avierich/beepy-hardware/KiCad/beepy.kicad_pcb

## KiCad design KiCad/beepy.kicad_pcb (2024-08-15)

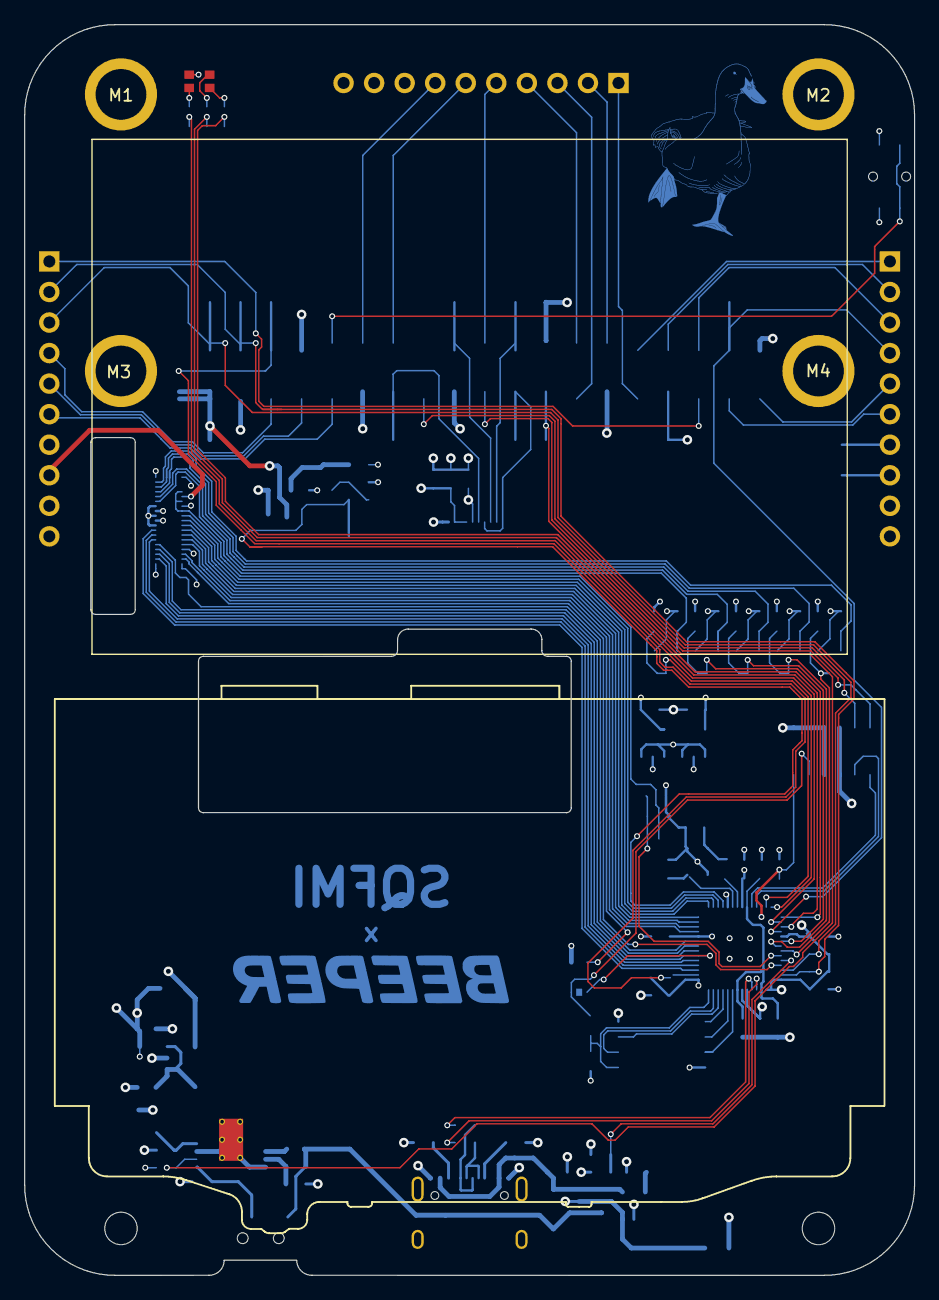
[picture p1: board beepy.kicad_pcb from above]

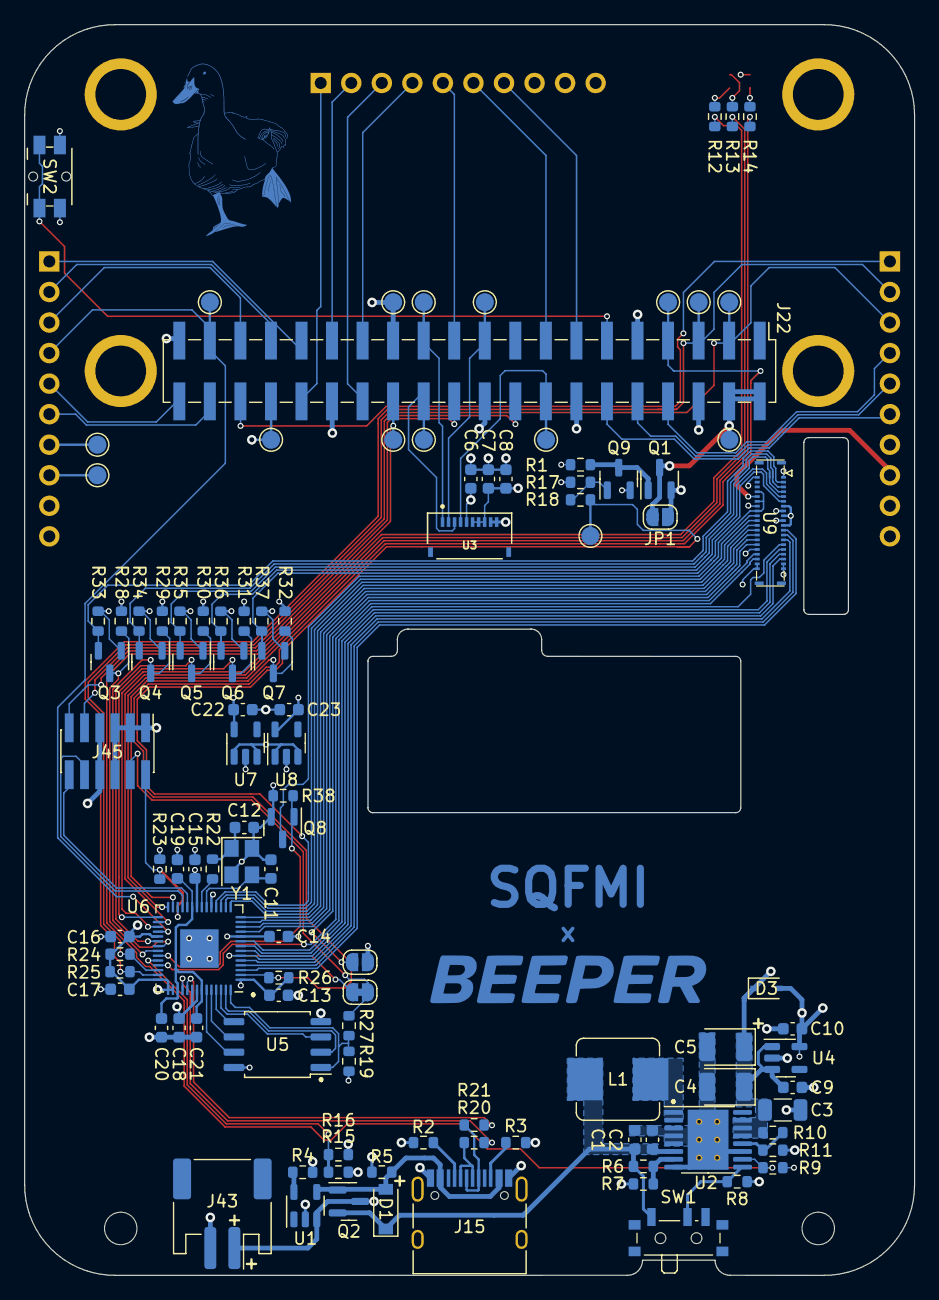
[picture p2: board beepy.kicad_pcb from below]

Board: 4 copper layers, 74.0 x 104.0 mm, 118 parts (115 on the bottom side), 100 nets.

Parts:
C1, C9, C10: 10uF; C_0603_1608Metric
C2, C6, C8: 100nF; C_0603_1608Metric
C3: 22uF; C_1206_3216Metric
C4, C5: 100uF; CP_EIA-3528-15_AVX-H
C7, C18, C21: 1uF; C_0603_1608Metric
C11, C12: 12pF; C_0603_1608Metric
C13, C14, C15, C16, C17, C19, C20, C22, C23: 0.1uF; C_0603_1608Metric
D1: B5819W; D_SOD-123
D2: Notification LED; FM-B2020RGBA-HG
D3: D_Schottky_Small; D_SOD-323
H1, H2: MountingHole; MountingHole_2.7mm_M2.5
J15: USB_C_Receptacle_USB2.0; USB_C_Receptacle_HRO_TYPE-C-31-M-12
J22: Pi Zero; PinHeader_2x20_P2.54mm_Vertical_SMD
J43: Battery; JST_PH_S2B-PH-SM4-TB_1x02-1MP_P2.00mm_Horizontal
J44: Header 1; PinHeader_1x10_P2.54mm_Vertical
J45: PRG_HEADER; PinHeader_2x06_P1.27mm_Vertical_SMD
J46: Header 2; PinHeader_1x10_P2.54mm_Vertical
J47: Header 3; PinHeader_1x10_P2.54mm_Vertical
JP1: PI PWR; SolderJumper-2_P1.3mm_Open_RoundedPad1.0x1.5mm
JP2: BOOTSEL_JUMPER; SolderJumper-2_P1.3mm_Bridged_RoundedPad1.0x1.5mm
JP3: SJ_MIC_VDD; SolderJumper-2_P1.3mm_Open_RoundedPad1.0x1.5mm
L1: 6.8uH/4A; L_Bourns_SRP7028A_7.3x6.6mm
M1, M2, M3, M4: MountingHole_2.5mm_Pad
Q1, Q2: SI2301; SOT-23
Q3, Q4, Q5, Q6, Q7, Q8: BSS138; SOT-23
Q9: S8050; SOT-23
R1, R4, R17, R19, R23, R26, R28, R29, R30, R31, R32, R33, R34, R35, R36, R37, R38: 10K; R_0603_1608Metric
R2, R3: 5.1K; R_0603_1608Metric
R5, R8, R15, R16: 100K; R_0603_1608Metric
R6, R10: 2M; R_0603_1608Metric
R7: 360K; R_0603_1608Metric
R9: 1M; R_0603_1608Metric
R11: 220K; R_0603_1608Metric
R12: 220; R_0603_1608Metric
R13, R14: 100; R_0603_1608Metric
R18: 330; R_0603_1608Metric
R20, R21: 27R; R_0603_1608Metric
R22, R27: 1K; R_0603_1608Metric
R24, R25: 4.7K; R_0603_1608Metric
REFe: SQFMI-DUCK-LOGO; SQFMI-DUCK-LOGO-BCU
SW1: ON/OFF; SW_SPDT_PCM12
SW2: Button; Panasonic_EVQPUL_EVQPUC
TP1, TP4, TP5, TP6, TP7, TP8, TP9, TP10, TP11, TP12, TP13, TP14, TP15, TP16, TP17: TestPoint; TestPoint_Pad_D1.5mm
U1: TP4054; SOT-23-5
U2: TPS61090; HTSSOP-16-1EP_4.4x5mm_P0.65mm_EP3.4x5mm_Mask2.46x2.31mm_The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
U3: LS027B7DH01; HRS_FH34SRJ-10S-0.5SH(50)
U4: AP2112K-3.3; SOT-23-5
U5: W25Q16JVSSIQ; SSOP-8_5.25x5.24mm_P1.27mm
U6: RP2040; QFN-56-1EP_7x7mm_P0.4mm_EP5.6x5.6mm
U7: ME6212C18M5G; SOT-23-5
U8: ME6212C28M5G; SOT-23-5
U9: BBQ20KBD; BM20B(0.8)-40DS-0.4V
Y1: XYDBPCNANF-12MHZ; Crystal_SMD_3225-4Pin_3.2x2.5mm

Connections:
+1V8: C22.1, Q3.1 (G), Q4.1 (G), Q5.1 (G), Q6.1 (G), Q7.1 (G), R33.2, R34.2, R35.2, R36.2, R37.2, U7.5 (OUT), U9.10 (1V8)
+2V8: C23.1, U8.5 (OUT), U9.8 (2V8)
+3V3: C6.1, C10.2, C13.1, C14.1, C15.1, C16.1, C17.1, C18.1, D2.3 (A), D3.2 (A), J44.7, J45.7, J45.8, J46.8, J47.8, JP3.1 (A), R9.2, R19.2, R23.1, R24.2, R25.1, R26.1, R28.2, R29.2, R30.2, R31.2, R32.2, TP13.1, U3.5 (DISP), U4.5 (VOUT), U5.8 (VDD), U6.1 (IOVDD), U6.10 (IOVDD), U6.22 (IOVDD), U6.33 (IOVDD), U6.42 (IOVDD), U6.43 (ADC_AVDD), U6.44 (VREG_VIN), U6.48 (USB_VDD), U6.49 (IOVDD), U7.1 (IN), U7.3 (EN), U8.1 (IN), U8.3 (EN), U9.34 (LEDA), U9.36 (LEDA)
+5V: C3.1, C4.1, C5.1, C7.1, C8.1, C9.1, D3.1 (K), J44.8, J47.7, JP1.1 (A), Q1.2 (S), R1.1, R10.1, TP14.1, U2.13 (VOUT), U2.14 (VOUT), U2.15 (VOUT), U3.6 (VDDA), U3.7 (VDD), U3.8 (EXTMODE), U4.1 (VIN), U4.3 (EN)
+BATT: J43.1, Q2.3 (D), R15.1, U1.3 (VBAT)
/Button: J22.11 (GPIO17), SW2.1 (A)
/DISP_CS: J22.24 (~CE0/GPIO8), TP6.1, U3.3 (SCS)
/DISP_EXTIN: J22.16 (GPIO23), TP1.1, U3.4 (EXTCOMIN)
/DISP_SCLK: J22.23 (SCLK0/GPIO11), TP8.1, U3.1 (SCLK)
/DISP_SI: J22.19 (MOSI0/GPIO10), TP5.1, U3.2 (SI)
/LBO: J22.26 (~CE1/GPIO7), R9.1, TP9.1, U2.10 (LBO)
/PI_HEADER_SWCLK: J22.22 (GPIO25), J45.11
/PI_HEADER_SWDIO: J22.18 (GPIO24), J45.9
/Pi_GPIO0: J22.27 (ID_SD/GPIO0), J46.4
/Pi_GPIO1: J22.28 (ID_SC/GPIO1), J46.3
/Pi_GPIO5: J22.29 (GCLK1/GPIO5), J46.2
/Pi_GPIO6: J22.31 (GCLK2/GPIO6), J44.1
/Pi_GPIO09: J22.21 (MISO0/GPIO9), J46.5
/Pi_GPIO12: J22.32 (PWM0/GPIO12), J46.1
/Pi_GPIO13: J22.33 (PWM1/GPIO13), J44.2
/Pi_GPIO14: J22.8 (GPIO14/TXD), J47.4
/Pi_GPIO15: J22.10 (GPIO15/RXD), J47.5
/Pi_GPIO16: J22.36 (GPIO16), J47.1
/Pi_GPIO18: J22.12 (GPIO18/PWM0), J47.6
/Pi_GPIO19: J22.35 (GPIO19/MISO1), J44.3
/Pi_GPIO20: J22.38 (GPIO20/MOSI1), J44.6
/Pi_GPIO21: J22.40 (GPIO21/SCLK1), J44.5
/Pi_GPIO22: J22.15 (GPIO22), J46.6
/Pi_GPIO26: J22.37 (GPIO26), J44.4, TP17.1, U6.32 (GPIO21)
/Pi_GPIO27: J22.13 (GPIO27), J46.7
/Pi_INT: J22.7 (GCLK0/GPIO4), R26.2, TP7.1, U6.2 (GPIO0)
/Pi_PWR: R18.1, TP10.1, U6.18 (GPIO15)
/Pi_SCL: J22.5 (SCL/GPIO3), J47.2, R25.2, TP12.1, U6.41 (GPIO29)
/Pi_SDA: J22.3 (SDA/GPIO2), J47.3, R24.1, TP11.1, U6.40 (GPIO28)
/RP2040/BATT_ADC: R15.2, R16.1, U6.38 (GPIO26)
/RP2040/COL1: U6.3 (GPIO1), U9.12 (COL1)
/RP2040/COL2: U6.4 (GPIO2), U9.13 (COL2)
/RP2040/COL3: U6.5 (GPIO3), U9.14 (COL3)
/RP2040/COL4: U6.9 (GPIO7), U9.15 (COL4)
/RP2040/COL5: U6.8 (GPIO6), U9.16 (COL5)
/RP2040/COL6: U6.7 (GPIO5), U9.17 (COL6)
/RP2040/COL7: JP2.1 (A), U6.6 (GPIO4), U9.18 (COL7)
/RP2040/D+: R21.1, U6.47 (USB_D+)
/RP2040/D-: R20.1, U6.46 (USB_D-)
/RP2040/KB_BL: Q8.1 (G), R38.1, U6.37 (GPIO25)
/RP2040/Keyboard/TP_MOTION_1V8: Q5.2 (S), R35.1, U9.4 (TP_MOTION)
/RP2040/Keyboard/TP_RESET_1V8: Q7.2 (S), R37.1, U9.6 (TP_RESET)
/RP2040/Keyboard/TP_SCL_1V8: Q4.2 (S), R34.1, U9.3 (TP_SCL)
/RP2040/Keyboard/TP_SDA_1V8: Q6.2 (S), R36.1, U9.5 (TP_SDA)
/RP2040/Keyboard/TP_SHUTDOWN_1V8: Q3.2 (S), R33.1, U9.2 (TP_SHUTDOWN)
/RP2040/LED_B: R14.1, U6.28 (GPIO17)
/RP2040/LED_G: R13.1, U6.30 (GPIO19)
/RP2040/LED_R: R12.1, U6.31 (GPIO20)
/RP2040/MIC: U6.39 (GPIO27), U9.23 (MIC)
/RP2040/QSPI_SCLK: U5.6 (SCK), U6.52 (QSPI_SCLK)
/RP2040/QSPI_SD0: U5.5 (DI/IO0), U6.53 (QSPI_SD0)
/RP2040/QSPI_SD1: U5.2 (DO/IO1), U6.55 (QSPI_SD1)
/RP2040/QSPI_SD2: U5.3 (~WP~/IO2), U6.54 (QSPI_SD2)
/RP2040/QSPI_SD3: U5.7 (~HOLD~/IO3), U6.51 (QSPI_SD3)
/RP2040/ROW1: U6.17 (GPIO14), U9.32 (ROW1)
/RP2040/ROW2: U6.16 (GPIO13), U9.31 (ROW2)
/RP2040/ROW3: U6.15 (GPIO12), U9.30 (ROW3)
/RP2040/ROW4: U6.14 (GPIO11), U9.29 (ROW4)
/RP2040/ROW5: U6.13 (GPIO10), U9.28 (ROW5)
/RP2040/ROW6: U6.12 (GPIO9), U9.27 (ROW6)
/RP2040/ROW7: U6.11 (GPIO8), U9.26 (ROW7)
/RP2040/TP_MOTION: Q5.3 (D), R30.1, U6.34 (GPIO22)
/RP2040/TP_RESET: Q7.3 (D), R32.1, U6.27 (GPIO16)
/RP2040/TP_SCL: Q4.3 (D), R29.1, U6.35 (GPIO23)
/RP2040/TP_SDA: Q6.3 (D), R31.1, U6.29 (GPIO18)
/RP2040/TP_SHUTDOWN: Q3.3 (D), R28.1, U6.36 (GPIO24)
/RP2040/~QSPI_CS: R19.1, R27.2, U5.1 (~CS~), U6.56 (~QSPI_CS)
BOOTSEL: J45.4, JP2.2 (B), R27.1
GND: C1.2, C2.2, C3.2, C4.2, C5.2, C6.2, C7.2, C8.2, C9.2, C10.1, C11.2, C12.2, C13.2, C14.2, C15.2, C16.2, C17.2, C18.2, C19.2, C20.2, C21.2, C22.2, C23.2, J15.A1 (GND), J15.A12 (GND), J15.B1 (GND), J15.B12 (GND), J22.6 (GND), J22.9 (GND), J22.14 (GND), J22.20 (GND), J22.25 (GND), J22.30 (GND), J22.34 (GND), J22.39 (GND), J43.2, J44.9, J44.10, J45.1, J45.3, J45.5, J45.6, J46.9, J46.10, J47.9, J47.10, Q8.2 (S), Q9.2 (E), R2.1, R3.1, R4.1, R5.2, R7.2, R8.1, R11.2, R16.2, R17.1, R38.2, SW2.2 (B), TP15.1, TP16.1, U1.2 (VSS), U2.3 (PGND), U2.4 (PGND), U2.5 (PGND), U2.8 (SYNC), U2.11 (GND), U2.17 (PAD), U3.9 (VSS), U3.10 (VSSA), U4.2 (GND), U5.4 (GND), U6.19 (TESTEN), U6.57 (GND), U7.2 (GND), U8.2 (GND), U9.1 (GND), U9.7 (GND), U9.9 (GND), U9.11 (GND), U9.19 (GND), U9.20 (GND), U9.21 (GND), U9.22 (AGND), U9.25 (GND), U9.40 (GND), Y1.2, Y1.4
unnamed: C12.1, R22.2, Y1.1
unnamed: C1.1, C2.1, D1.1 (K), L1.1, Q2.2 (S), R6.1, SW1.1 (A), U2.6 (VBAT)
unnamed: D2.2 (BK), R14.2
unnamed: D2.4 (GK), R13.2
unnamed: D2.1 (RK), R12.2
unnamed: J15.A5 (CC1), R2.2
unnamed: J15.B5 (CC2), R3.2
unnamed: J22.2 (5V), J22.4 (5V), JP1.2 (B), Q1.3 (D), TP4.1
unnamed: JP3.2 (B), U9.24 (MIC_VDD)
unnamed: L1.2, U2.1 (SW), U2.2 (SW)
unnamed: Q1.1 (G), Q9.3 (C), R1.2
unnamed: Q8.3 (D), U9.33 (LEDK), U9.35 (LEDK), U9.37 (LEDK)
unnamed: Q9.1 (B), R17.2, R18.2
unnamed: R8.2, SW1.2 (B), U2.9 (EN)
unnamed: R4.2, U1.5 (PROG)
unnamed: R10.2, R11.1, U2.12 (FB)
unnamed: R6.2, R7.1, U2.7 (LBI)
unnamed: C19.1, C20.1, C21.1, U6.23 (DVDD), U6.45 (VREG_VOUT), U6.50 (DVDD)
unnamed: C11.1, U6.20 (XIN), Y1.3
unnamed: R22.1, U6.21 (XOUT)
SWCLK: J45.12, U6.24 (SWCLK)
SWDIO: J45.10, U6.25 (SWDIO)
USB_D+: J15.A6 (D+), J15.B6 (D+), R21.2
USB_D-: J15.A7 (D-), J15.B7 (D-), R20.2
VBUS: D1.2 (A), J15.A4 (VBUS), J15.A9 (VBUS), J15.B4 (VBUS), J15.B9 (VBUS), Q2.1 (G), R5.1, U1.4 (VDD)
~RESET: J45.2, R23.2, U6.26 (RUN)
