avierich/beepy-hardware/(commit log)

2024-08-15 Importing to KiCAD 8 and using pin headers instead of springs
    [bbq20kbd.kicad_sch, beepy.kicad_pcb, beepy.kicad_sch, rp2040.kicad_sch]
2024-08-15 Swapping NOR chip for equivalent
    [rp2040.kicad_sch]
2024-08-15 Moving header designator
    [beepy.kicad_pcb]
