avierich/beepy-hardware/(notices)

Notices in the files:
KiCad/bbq20kbd.kicad_sch:
CERN Open Hardware Licence v1.2
